marawangamal/propellor-control-system/README.md

# Propeller-Control-System

### Contol of a propeller is to achieve 3 primary objectives: 

1. Step to 45 degrees given, Overshoot, Settling time and Rise time minimum requirements
2. Recover from a perterbation given same requirements
3. Trace a sine wave input

##### More details in report attached

##

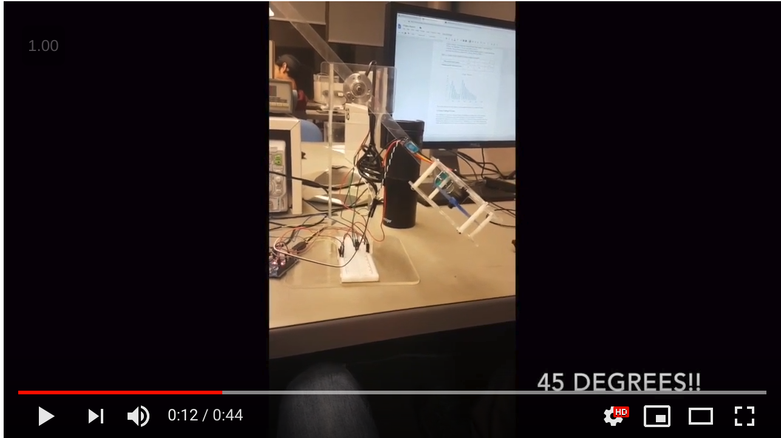
[picture p1: cover.png]
IMAGE ALT TEXT (https://www.youtube.com/watch?v=6NscMEbjdvo&feature=youtu.be "Video Title")
